VibrasticLab/ehealth-iot/README.md

# ehealth-iot

This repository hold some sources tree for our IOT agent
