VibrasticLab/ehealth-iot/document/cough-edge-duplicate/duplikat.tex

\documentclass[12pt,]{article}
\usepackage[utf8]{inputenc}
\usepackage[T1]{fontenc}
\usepackage{geometry}
\usepackage{hyperref}
\usepackage{booktabs}
\usepackage{graphicx}
\usepackage{pdfpages}

\geometry{
	a4paper,
	left=15mm,
	right=10mm,
	top=10mm,
	bottom=10mm,
}

\title{\Large \bf
	Laporan Kegiatan Duplikat Prototype IoT Batuk Analyzer
}

\author{Achmadi ST MT}

\date{}

\begin{document}
	\maketitle
	\thispagestyle{empty}
	\pagestyle{empty}
	
	\section{Pengeluaran}
	
	\begin{tabular}{|l|l|l|}
		\toprule
		Item & Price & URL \\
		\midrule
		RaspberryPi-4 & Rp. 2.220.000 & \href{https://digiwarestore.com/en/raspberry-board/raspberry-pi-4-ram-2gb-made-in-uk-mini-pc-raspi-4-442339.html}{Digiware} \\
		RaspberryPi-4 Case & Rp. 87.900 & \href{https://digiwarestore.com/en/raspberry-accessories/case-for-raspberry-pi-4-white-abs-with-cooling-fan-and-heat-sink.html}{Digiware} \\
		RaspberryPi-4 Adaptor & Rp. 139.500 & \href{https://digiwarestore.com/en/adaptor/raspberry-pi-4-usb-c-power-supply-5v-3a-644174.html}{Digiware} \\
		Stacking Header & Rp. 48.000 & \href{https://digiwarestore.com/en/pcb-female/header-female-long-pin-stackable-1x10-10-pin-323119.html}{Digiware} \\
		Mic MEMS I2S & Rp. 191.000 & \href{https://www.tokopedia.com/aifrobotic/inmp441-omnidirectional-microphone-module-mems-i2s-interface}{Tokopedia} \\
		Micro SDCard 16GB C10 & Rp. 67.500 & Sakinah \\
		Box Container 6L & Rp. 34.000 & Sakinah \\
		Solder Dekko Biru & Rp. 72.500 & Berkat Elektronik \\
		\midrule
		Total & Rp. 2.860.400 & - \\
		\bottomrule
	\end{tabular}

	\section{Result}
	
	\centering
	\begin{figure}[!ht]
		\centering
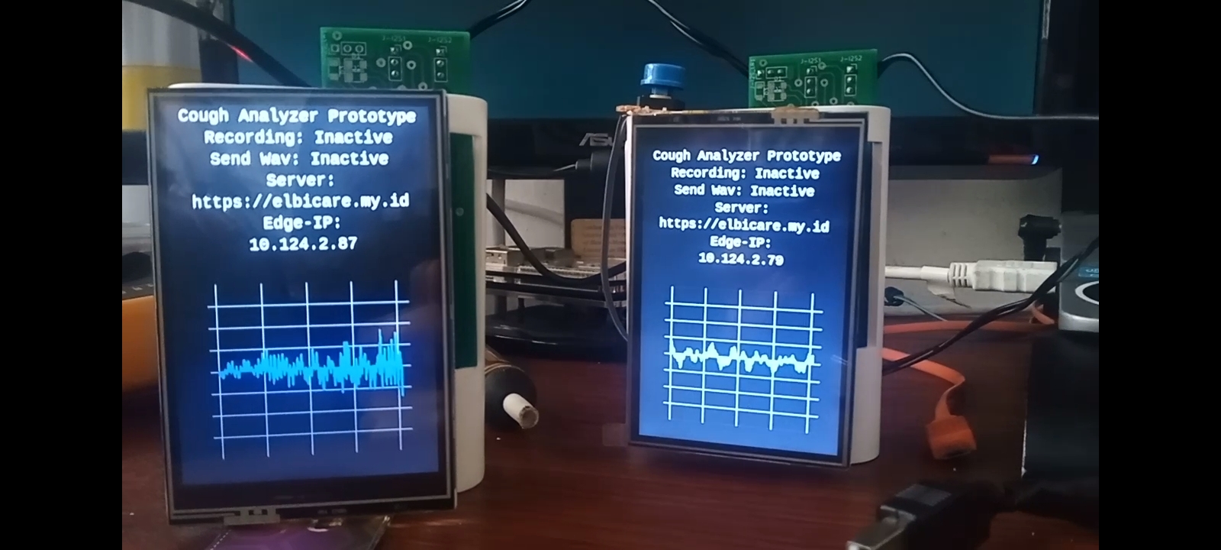
[picture p13: document/cough-edge-duplicate/images/hasil_duplikat.jpg]
		
	\end{figure}

	\newpage
	\section{Nota}
	
	\centering
	\begin{figure}[!ht]
		\centering
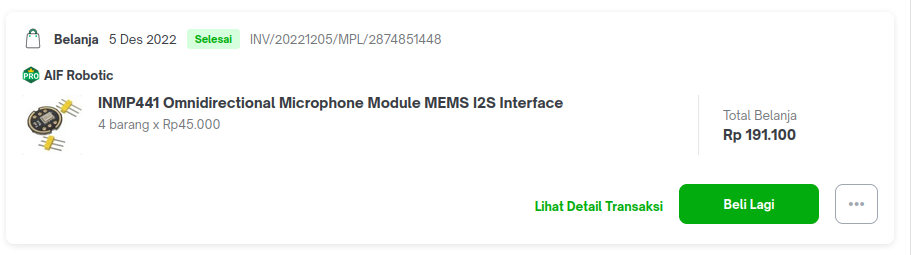
[picture p14: document/cough-edge-duplicate/images/mic_mems_i2s.png]
		
	\end{figure}

	\includepdf[pages=-]{pdf/nota_batuk_duplikat.pdf}

\end{document}
