VibrasticLab/ehealth-iot/coughgui/olahdata/Readme.md

# Normal Data Collections

## Data Collection Directory
- Lab (June 2023): [Directory](https://github.com/VibrasticLab/ehealth-iot/tree/master/coughgui/olahdata/normal/lab_062023).
- Probolinggo (October 2023): [Directory](https://github.com/VibrasticLab/ehealth-iot/tree/master/coughgui/olahdata/normal/probo_07102023).

## Processing Example

Here some Python example for processing audio example: [Notebook](https://github.com/VibrasticLab/ehealth-iot/blob/master/coughgui/olahdata/TestMFCCF0.ipynb).

## Documentation

### Probolinggo

Coming to Public Health Care:

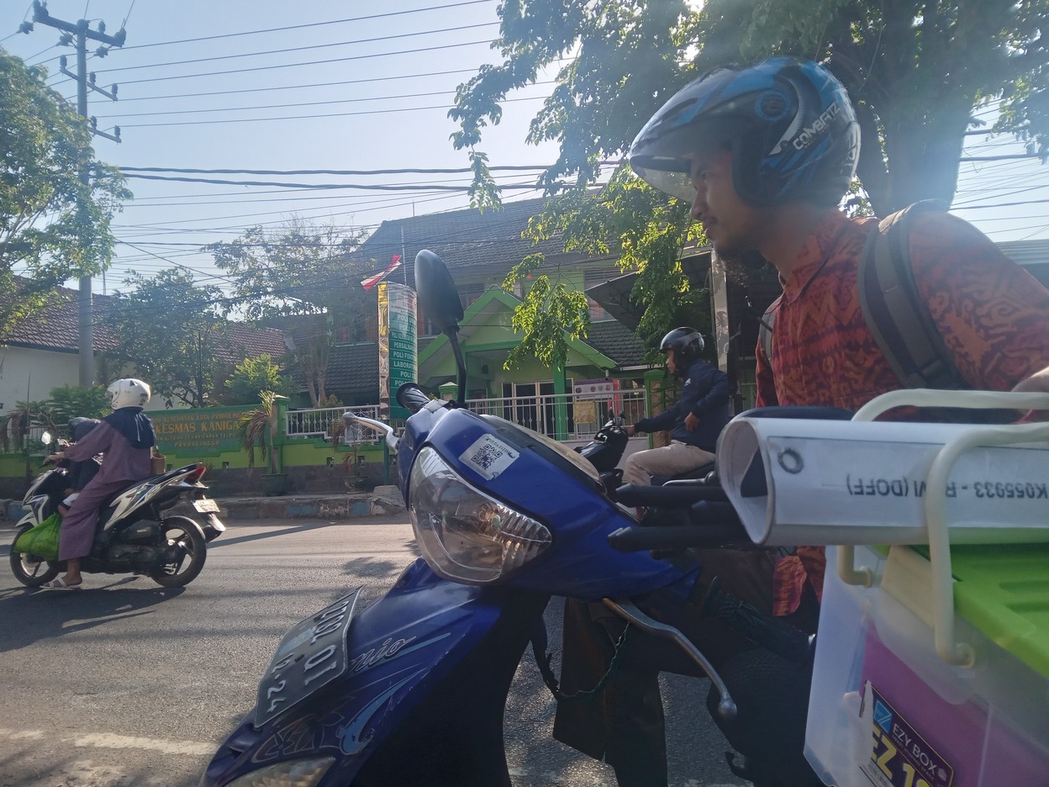
[picture p15: coughgui/olahdata/images/20231006_071643.jpg]


Form of Consent:

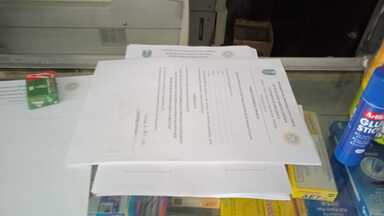
[picture p16: coughgui/olahdata/images/IMG-20231006-WA0013.jpg]


Briefing:

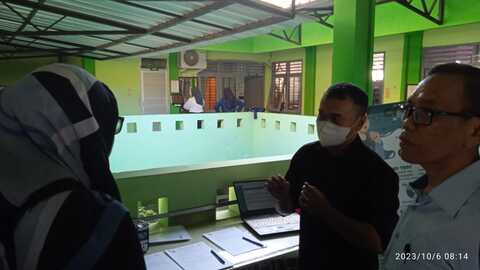
[picture p17: coughgui/olahdata/images/IMG-20231006-WA0009.jpg]


Cough Sampling:

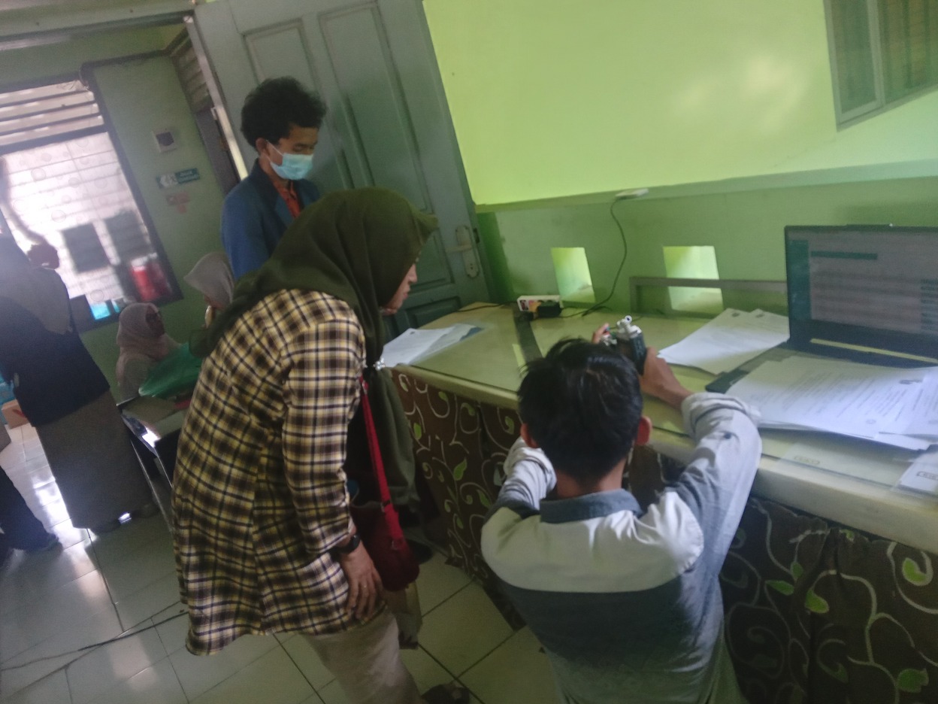
[picture p18: coughgui/olahdata/images/20231006_103510.jpg]


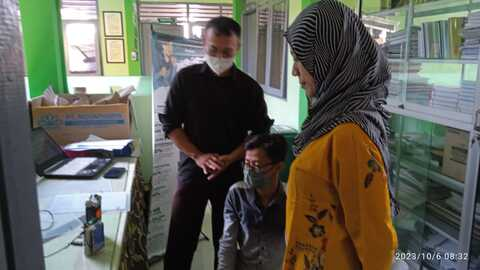
[picture p19: coughgui/olahdata/images/IMG-20231006-WA0010.jpg]


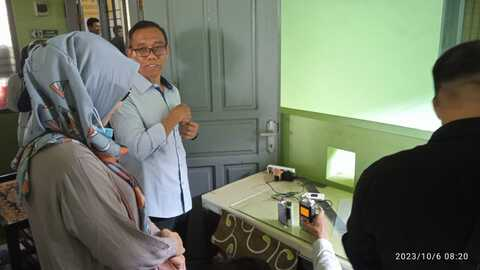
[picture p20: coughgui/olahdata/images/IMG-20231006-WA0011.jpg]


Personels:

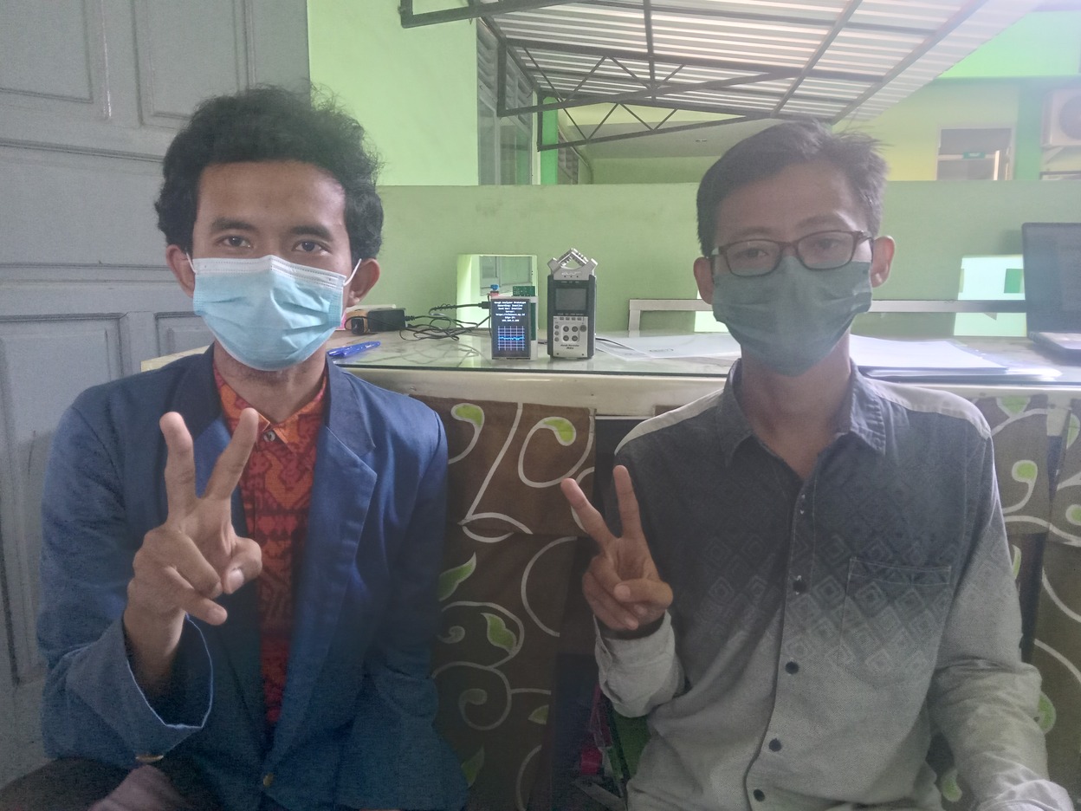
[picture p21: coughgui/olahdata/images/20231006_083502.jpg]


### Lab

Not Found
