VibrasticLab/ehealth-iot/coughgui/diagram/cough.png

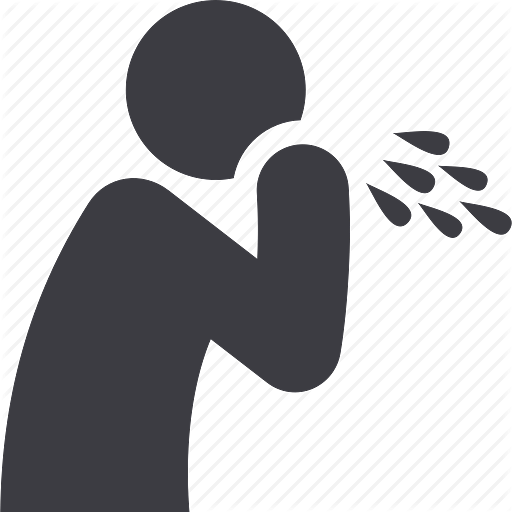
coughgui/diagram/cough.png
