VibrasticLab/ehealth-iot/coughgui/diagram/raspi4.jpg

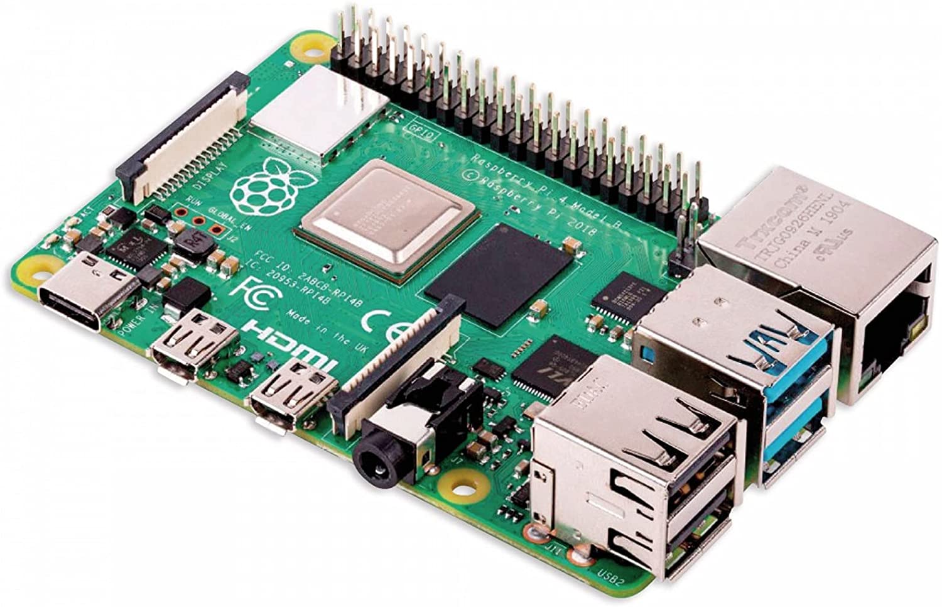
coughgui/diagram/raspi4.jpg
