VibrasticLab/ehealth-iot/coughgui/diagram/workflow.png

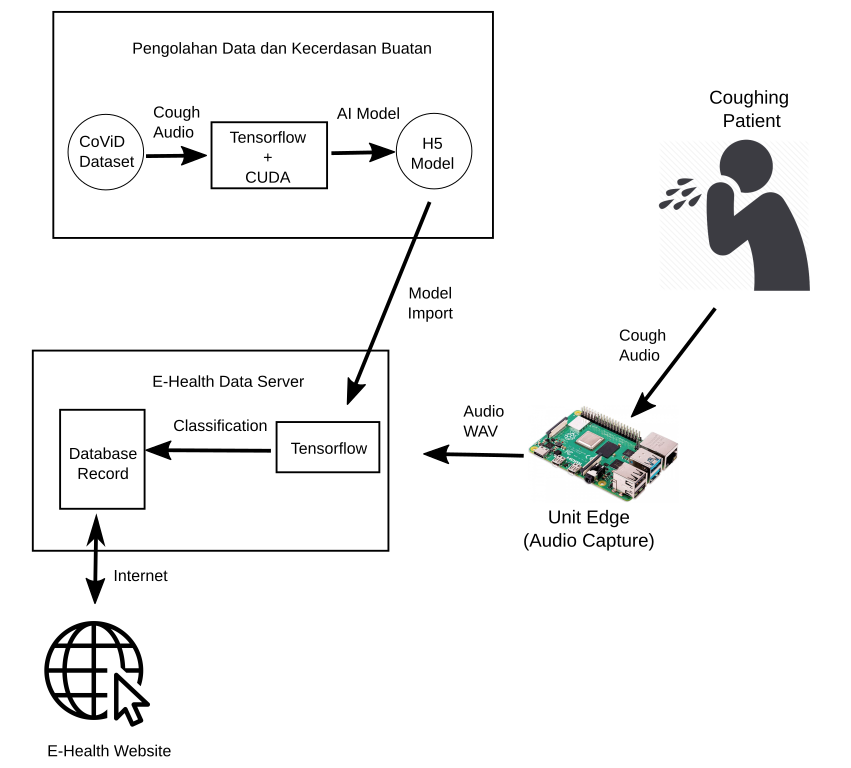
coughgui/diagram/workflow.png
