VibrasticLab/ehealth-iot/document/sop_ambil_data/images/proto.jpg

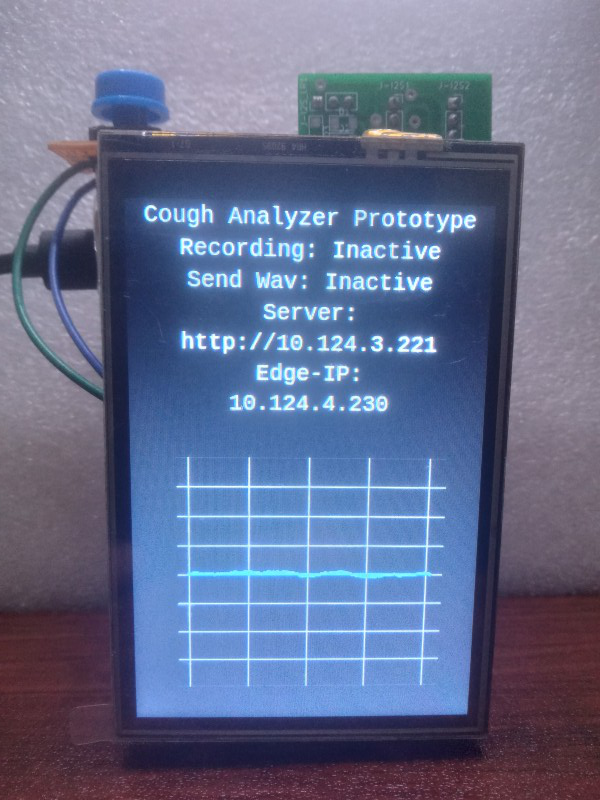
document/sop_ambil_data/images/proto.jpg
