VibrasticLab/ehealth-iot/document/steto_proto/images/steto_bot.png

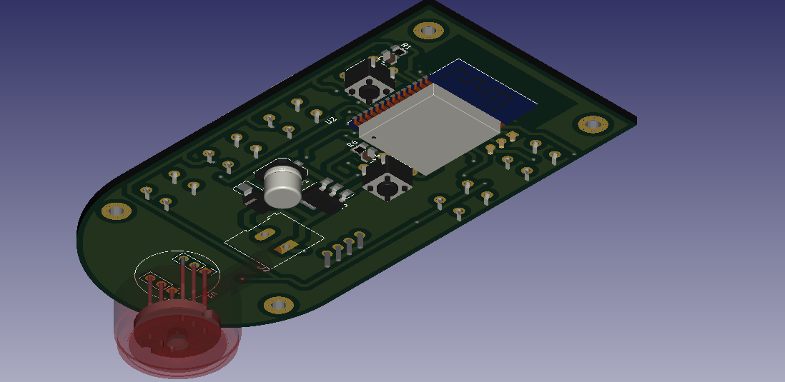
document/steto_proto/images/steto_bot.png
