VibrasticLab/ehealth-iot/document/steto_proto/images/steto_top.png

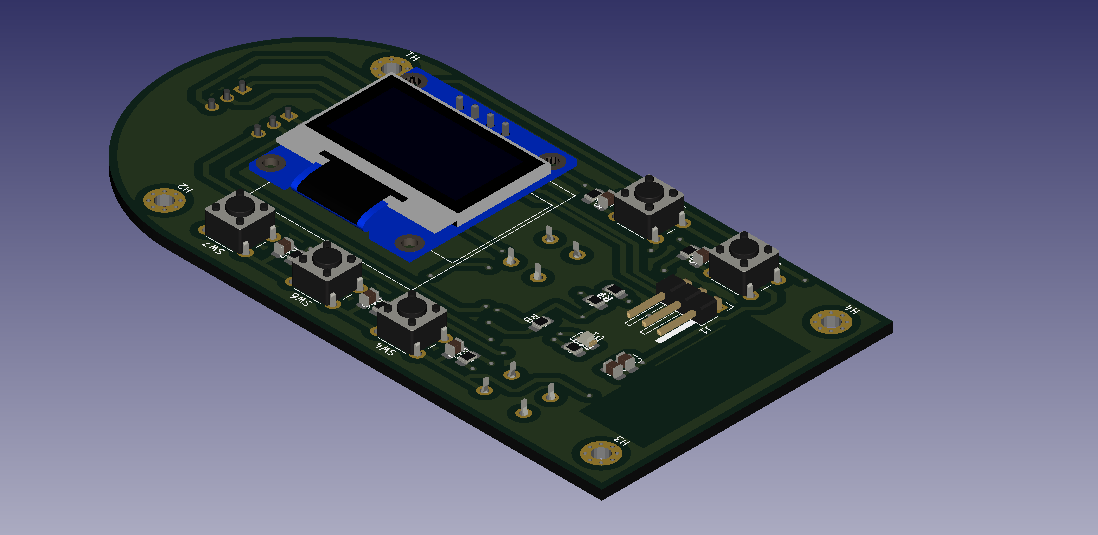
document/steto_proto/images/steto_top.png
