VibrasticLab/ehealth-iot/esp32-mic-a2dp/main/my_mic.c

/**
 * example in use: https://www.esp32.com/viewtopic.php?t=15185
 *
 * If you'd like to play them back to the built-in DAC,
 * what i've found is that the DAC expects non-signed samples,
 * so basically you cast each sample to an int32_t,
 * add 0x8000, then cast back to a uint16_t.
 */

#include <stdint.h>
#include <stdio.h>
#include <string.h>
#include "freertos/FreeRTOS.h"
#include "freertos/task.h"
#include "freertos/event_groups.h"
#include "esp_system.h"
#include "esp_now.h"
#include "esp_console.h"
#include "driver/i2s.h"
#include "driver/uart.h"
#include "argtable3/argtable3.h"

#include "my_mic.h"
#include "myconfig.h"

uint8_t recStatus;

static int micRaw(uint16_t* buffRaw){
    esp_err_t errMic;
    int i, samplesRead;
    size_t bytesRead = 0;
    uint8_t buff32[ESP_NOW_MAX_DATA_LEN*4] = {0};

    errMic = i2s_read(I2S_NUM_0, &buff32, sizeof(buff32), &bytesRead, 100);
    samplesRead = bytesRead/4;

    for(i=0;i<samplesRead;i++){
        uint8_t mid = buff32[i*4+2];
        uint8_t msb = buff32[i+4+3];
        uint16_t raw = (((uint32_t)msb)<<8) + ((uint32_t)mid);
        memcpy(&buffRaw[i], &raw, sizeof(raw));
    }

    if(errMic!=ESP_OK)printf("MIC_ERROR\r\n");

    return samplesRead;
}

static void micTask(void *pvParameter){
    int vread;
    uint16_t i;
    uint16_t rec16[ESP_NOW_MAX_DATA_LEN] = {0};
    recStatus = 0;

    while(1){
        if(recStatus==1){
            vread = micRaw(rec16);
            for(i=0;i<vread;i++){
                printf("%i,",rec16[i]);
            }
            printf("0\r\n");
        }
        vTaskDelay(100 / portTICK_PERIOD_MS);
    }
}

static int micGet(int argc, char **argv){
    int vread;
    uint16_t i;
    uint16_t rec16[ESP_NOW_MAX_DATA_LEN] = {0};
    recStatus = 0;

    vread = micRaw(rec16);
    for(i=0;i<vread;i++){
        printf("%i,",rec16[i]);
    }
    printf("0\r\n");

    return 0;
}

static int get_raw(int argc, char **argv){
    if(recStatus==0){recStatus=1;}
    else{recStatus=0;}

    return 0;
}

static void micRegister(void){
    const esp_console_cmd_t cmd = {
        .command = "mic",
        .help = "Test 250 data Mic (loop)",
        .hint = NULL,
        .func = &get_raw,
    };

    const esp_console_cmd_t get = {
        .command = "get",
        .help = "Test 250 data Mic (once)",
        .hint = NULL,
        .func = &micGet,
    };

    esp_console_cmd_register(&cmd);
    esp_console_cmd_register(&get);
}

void micInit(void){

    i2s_config_t micConf = {
        .mode = (i2s_mode_t) (I2S_MODE_MASTER|I2S_MODE_RX),
        .sample_rate = 44100,
        .bits_per_sample = I2S_BITS_PER_SAMPLE_32BIT,
        .channel_format = I2S_CHANNEL_FMT_ONLY_LEFT,
        .communication_format = (i2s_comm_format_t) (I2S_COMM_FORMAT_STAND_I2S | I2S_COMM_FORMAT_STAND_MSB),
        .intr_alloc_flags = ESP_INTR_FLAG_LEVEL1,
        .dma_buf_count = 4,
        .dma_buf_len = ESP_NOW_MAX_DATA_LEN * 4,
        .use_apll = true,
        .tx_desc_auto_clear = false,
        .fixed_mclk = 0,
    };

    if(i2s_driver_install(I2S_NUM_0, &micConf, 0, NULL) != ESP_OK){
        printf("I2S driver install error\r\n");
    }

    i2s_pin_config_t micPin = {
        .bck_io_num = 14,
        .ws_io_num = 15,
        .data_out_num = I2S_PIN_NO_CHANGE,
        .data_in_num = 34, // or 23
    };

    if(i2s_set_pin(I2S_NUM_0, &micPin) != ESP_OK){
        printf("I2S pin set error\r\n");
    }

    xTaskCreate(&micTask, "mic_task", 4096, NULL, 5, NULL);

    micRegister();
}
