VibrasticLab/ehealth-iot/esp32-mic-a2dp/main/myconfig.h

/**
 * @file    myconfig.h
 * @brief   Global config header.
 *
 * @addtogroup Main
 * @{
 */

#ifndef _MY_CONFIG_H_
#define _MY_CONFIG_H_

#define BLINK_GPIO  2
#define BLINK_DELAY 100 

#define CONFIG_ESP_CONSOLE_UART_NUM 0
#define UART_USE_PROMPT 0

#endif

/** @} */
