VibrasticLab/ehealth-iot/(commit log)

2021-08-24 circuit shield
    [lcdmicrpi.kicad_pcb, lcdmicrpi.sch]
2021-08-24 pcb shield
    [lcdmicrpi.kicad_pcb]
2021-08-24 PCB order
2021-08-30 write record still failed
    [calsa.c]
2021-09-01 write out.raw still failed
    [calsa.c]
2021-09-06 start work on esp32
2021-11-22 mic still not work as expected
    [my_mic.c]
2021-12-19 both numpy and frame string works
2022-01-27 update raspberry
2022-01-27 raspberry librosa
2022-01-28 Try build Tensorflow Lite in Raspberry Pi
2022-12-07 Laporan Duplikat Prototype
2022-12-08 Project Stetoskop
    [esp32steto.kicad_pcb, esp32steto.kicad_sch, lcdmicrpi.kicad_pcb, lcdmicrpi.kicad_sch]
2022-12-08 Progress PCB Stetoskop
    [esp32steto.kicad_sch]
2022-12-08 Schematic Drafted
    [esp32steto.kicad_sch]
2022-12-08 Decoupling Cap only on ESP32
    [esp32steto.kicad_sch]
2022-12-08 Progress PCB Steto
    [esp32steto.kicad_sch]
2022-12-08 Start to wiring
    [esp32steto.kicad_pcb, esp32steto.kicad_sch]
2022-12-08 PCB Done
    [esp32steto.kicad_pcb]
2023-01-10 some progress
    [esp32steto.kicad_pcb, lcdmicrpi.kicad_pcb]
2023-04-03 KiCAD version Update
2023-04-09 Update KiCAD
